LBroKerR/ESP32_Thermostats/Thermostats/configs/README.md

# included libraries
    - Arduino_JSON
    - AsyncTCP
    - DHT_kxn
    - ESP_Async_WebServer
    - ESP32Time
    - FreeRTOS
    - lvgl -> lv_conf.h (lv_config_template.h shall changed by mine cofig file)
    - ModbusMaster
    - Adafruit_SSD1306
    - TFT_eSPI -> User_Setup.h
    - WebSockets
    - WiFi
    - XPT2046_Touchscreen
