LBroKerR/ESP32_Thermostats/Summarise_pictures/README.md

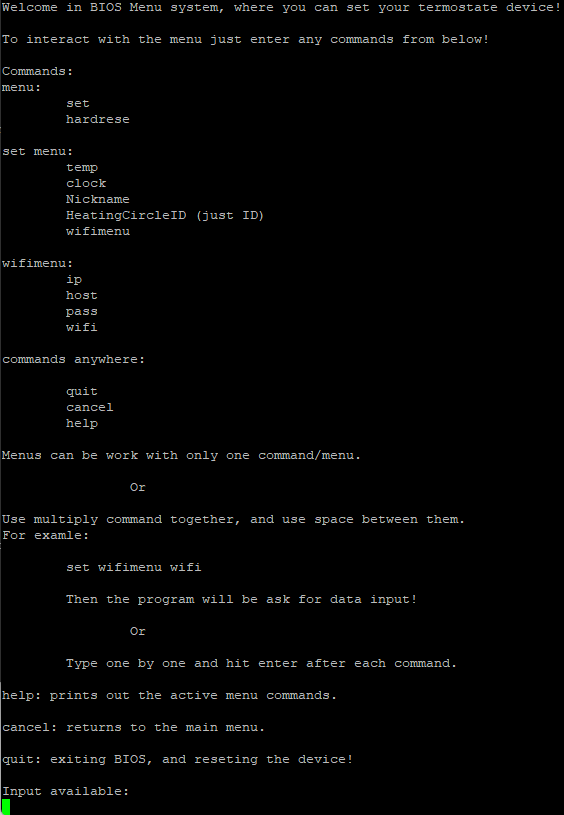
[picture p1: Summarise_pictures/serial task begining in espcarryable.png]

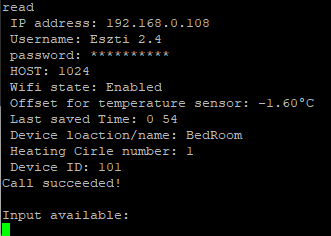
[picture p2: Summarise_pictures/eeprom read.png]

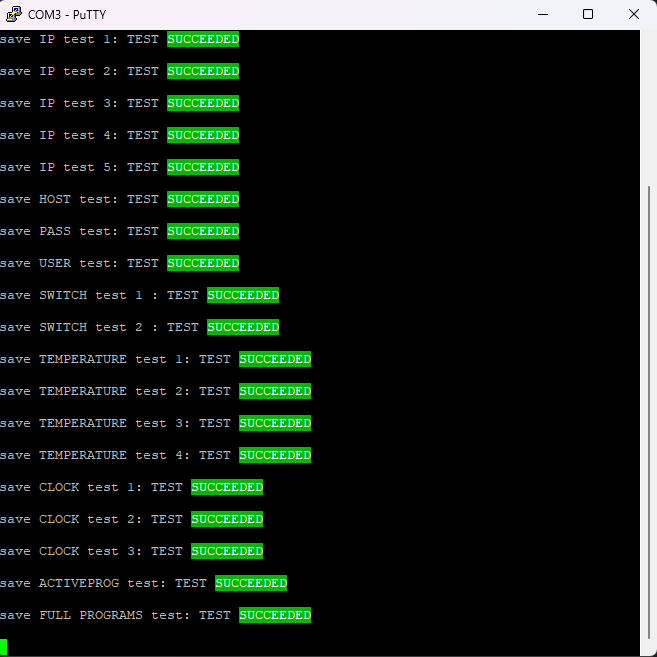
[picture p3: Summarise_pictures/eeprom test.png]

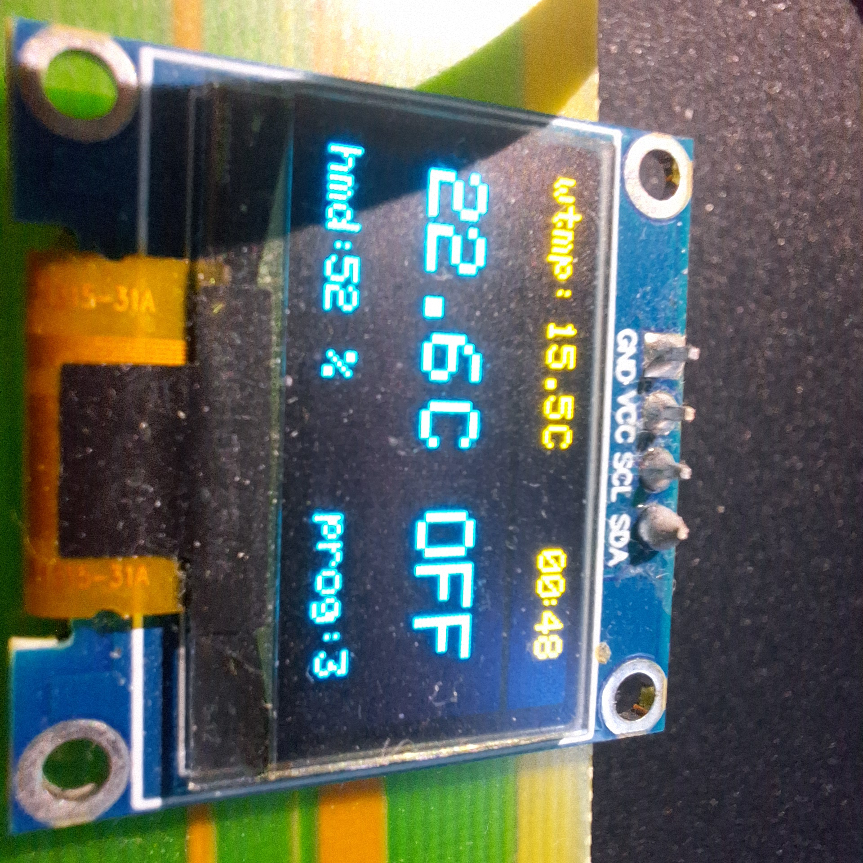
[picture p4: Summarise_pictures/espcarryable main screen.jpg]

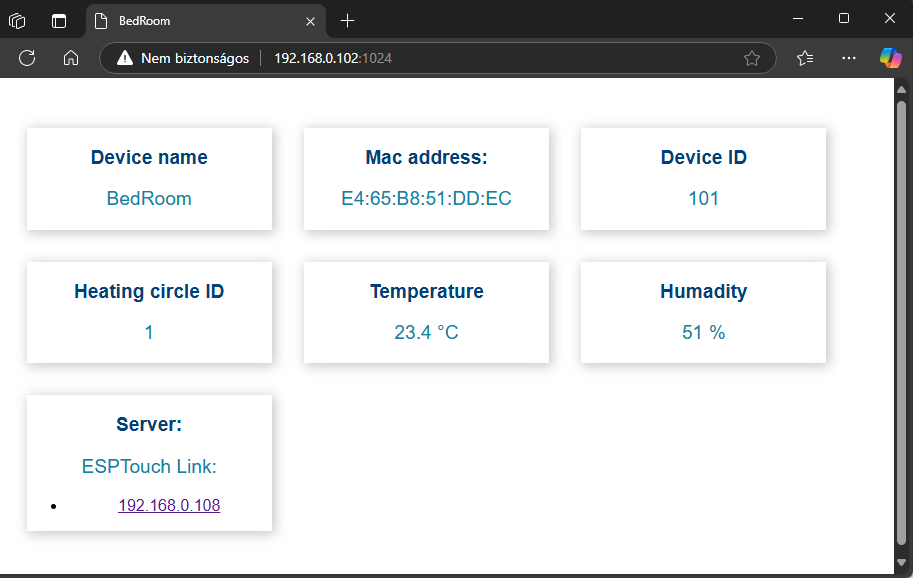
[picture p5: Summarise_pictures/espcarryable webpage.png]

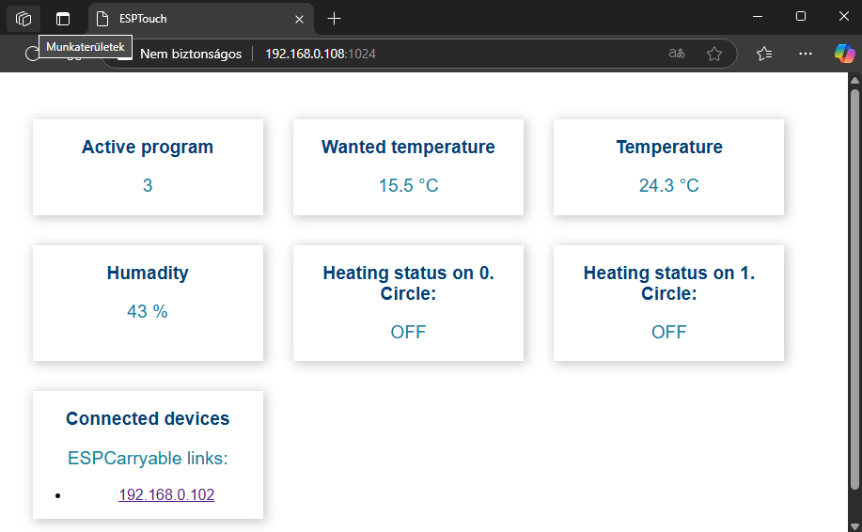
[picture p6: Summarise_pictures/esptouch webpage.png]

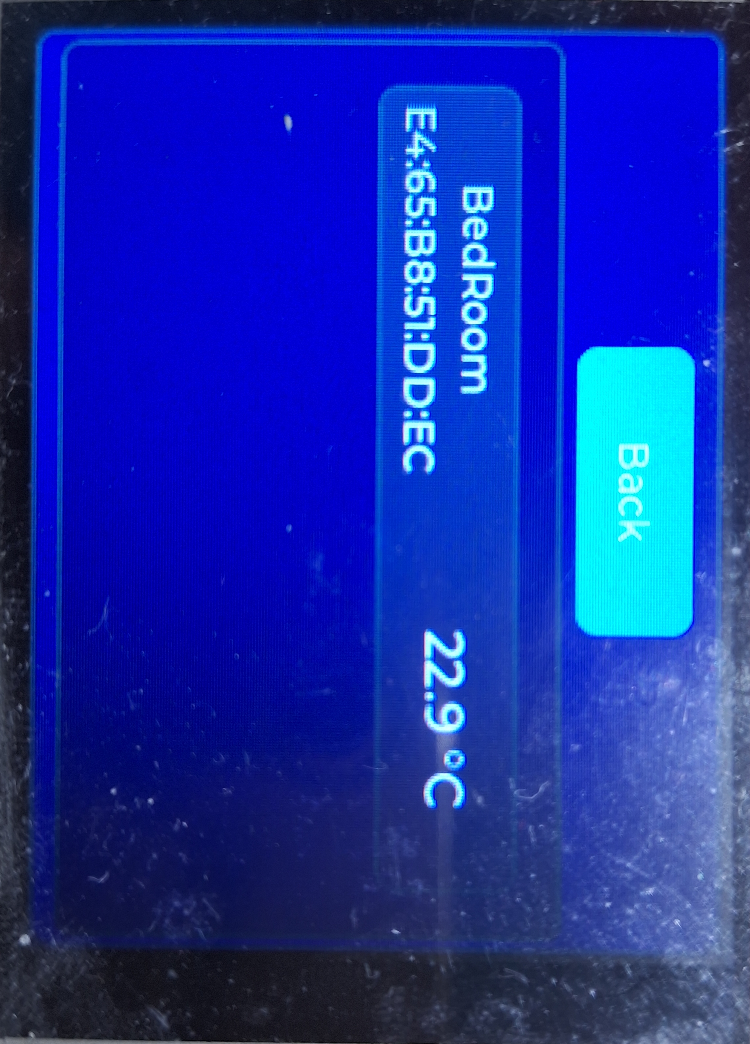
[picture p7: Summarise_pictures/external device srceen.jpg]

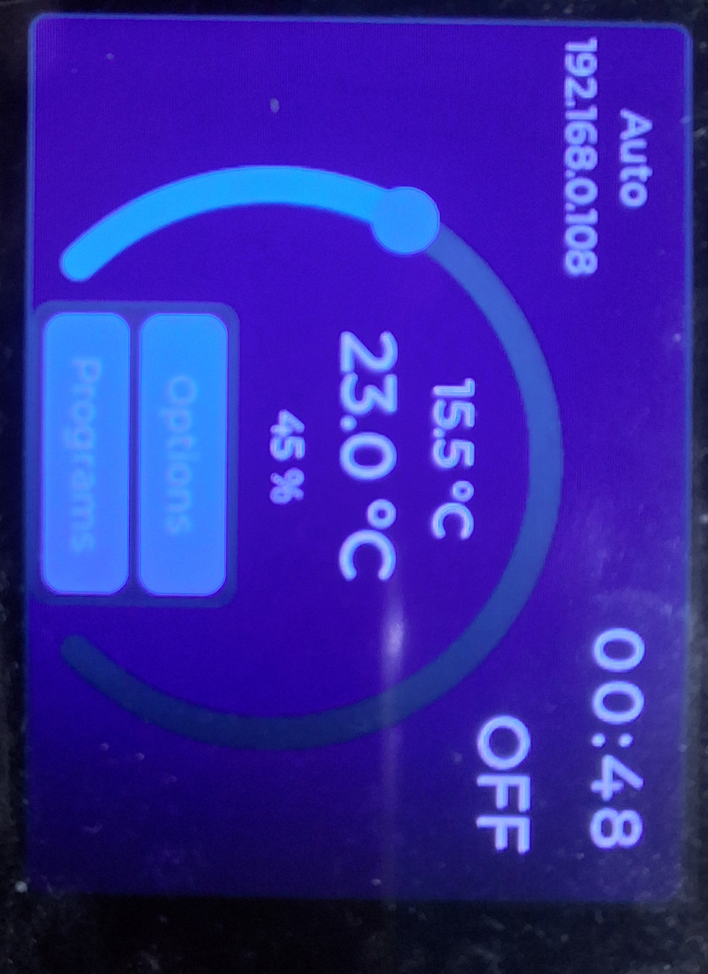
[picture p8: Summarise_pictures/main screen.jpg]

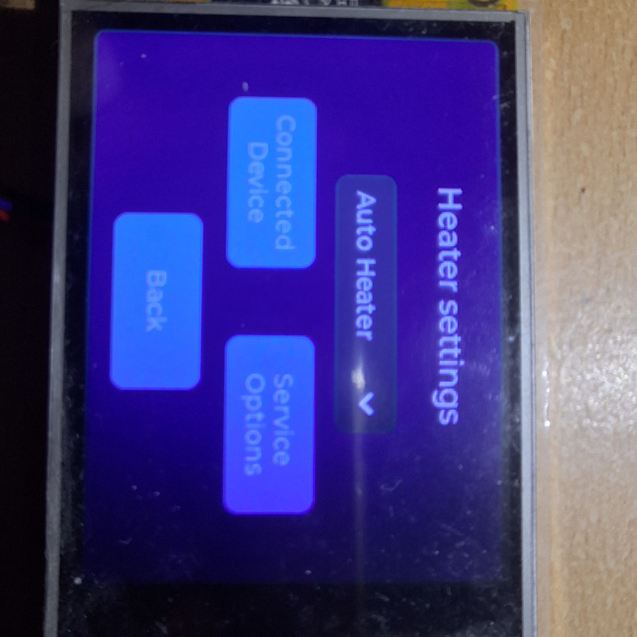
[picture p9: Summarise_pictures/options screen 2.jpg]


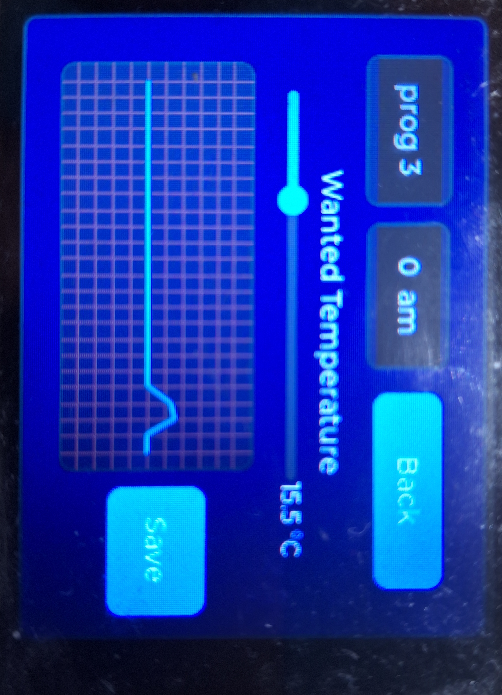
[picture p10: Summarise_pictures/prog screen.jpg]
