LBroKerR/ESP32_Thermostats/Thermostats/EspTouch/ESPTouch/Taskhandler/Init_task/InitTask.h

#pragma once
#ifndef INITTASK_H
#define INITTASK_H

#include <Arduino.h>
#include "DataHandler.h"
#include <EEPROM.h>
#include "EEPROMhandler.h"

#define EEPROM_SIZE      0x0450

#define UPSIZE           0x0015


class InitTask{
    DataHandler* WifiInit(DataHandler *obj);

    DataHandler* ProgInit(DataHandler *obj);
    DataHandler* ClockInit(DataHandler *obj);
    DataHandler* HeaterInit(DataHandler *obj);
    DataHandler* DataInit(DataHandler *obj);
    void saveData(DataHandler*);
    void print(DataHandler*parameters);
public:
    DataHandler *main(DataHandler*);
    void save(DataHandler*);
};
#endif // INITTASK_H
