LBroKerR/ESP32_Thermostats/Thermostats/Branch/ESPTouch/programs.cpp

#include "programs.h"

programs::programs(){
    active_program_index.set_variable(0);
    ProgHour_index.set_variable(0);
    active_program_index_changed=false;
    Wanted_temp.set_variable(DEFAULT_TEMP);
    wtmp_changed=false;
    manual_mode.set_variable(false);
    programs_Changed=false;
    ProgHour_index_changed=false;
    server_update_wtmp=false;
    server_update_prog_index=false;
    for(unsigned i=0; i<NUMBER_OF_PROGRAM; i++){
        Programs[i]=new float[SIZE_OF_A_PROGRAM];
        for(unsigned k=0; k<SIZE_OF_A_PROGRAM; k++){
            Programs[i][k]=DEFAULT_TEMP;
        }
    }
}
programs::~programs(){
    //void
    for(unsigned i=0; i<NUMBER_OF_PROGRAM; i++){
        delete[] Programs[i];
    }
    delete[] Programs;
}

//setters
void programs::set_server_update_prog_index(bool param){
    server_update_prog_index=param;
}
void programs::set_active_program_index(unsigned const param){
    if(param>=0 && param<NUMBER_OF_PROGRAM){
        if(active_program_index.set_variable(param)){
            set_active_program_index_changed(true);
        }
    }
}
void programs::set_Wanted_temp(float param){
    float wtmp=0.0;
    if(param>=MIN_TEMP && param<=MAX_TEMP){
        Wanted_temp.get_variable(&wtmp);
        if(wtmp!=param){
            if(Wanted_temp.set_variable(param)){
            set_server_update_wtmp(true);
            //set_wtmp_changed(true);
            }
        }
    }
}
void programs::set_programs(float* param, unsigned const size, unsigned const index){
    if(param!=nullptr && size<SIZE_OF_A_PROGRAM && size>0 && index>=0 && index<NUMBER_OF_PROGRAM){
        for(unsigned i=0; i<size; i++){
            Programs[index][i]=param[i];
        }
    }
}
    void programs::set_programs(double* param, unsigned const index){
    if(param!=nullptr && index>=0 && index<NUMBER_OF_PROGRAM){
        for(unsigned i=0; i<SIZE_OF_A_PROGRAM; i++){
            Programs[index][i]=(float)param[i];
        }
    }
}
bool programs::set_program_element( unsigned hour, float data){
    if(hour<SIZE_OF_A_PROGRAM && hour>=0 && data>=MIN_TEMP && data<=MAX_TEMP ){
        get_programs()[hour]=data;
        set_programs_Changed(true);
        return true;
    }
    return false;
}
bool programs::set_program_element( float data){
    unsigned index=0;
    if(data>=(float)MIN_TEMP && data<=(float)MAX_TEMP){
        get_ProgHour_index(&index);
        get_programs()[index]=data;
        set_programs_Changed(true);
        return true;
    }
    return false;
}

void programs::set_active_program_index_changed(bool const param){
    active_program_index_changed=param;
}
void programs::set_wtmp_changed(bool const param){
    wtmp_changed=param;
}
void programs::set_manual_mode(bool const param){
    manual_mode.set_variable(param);
}
void programs::set_programs_Changed(bool const param){
    programs_Changed=param;
}
void programs::set_ProgHour_index(unsigned param){
    unsigned tmp=0;
    get_ProgHour_index(&tmp);
    if(param!=tmp){
        ProgHour_index.set_variable(param);
        set_ProgHour_index_changed(true);
    }
}
void programs::set_ProgHour_index_changed(bool param){
        ProgHour_index_changed=param;
}
void programs::set_server_update_wtmp(bool param){
    server_update_wtmp=param;
}

void programs::set_received_index(unsigned param, unsigned hour_index){
    unsigned index=0;
    if(param>=0 && param<NUMBER_OF_PROGRAM){
        active_program_index.set_variable(param);
        set_Wanted_temp(get_programs()[hour_index]);
        set_active_program_index_changed(true);
    }
}
void programs::set_received_wtmp(float param){
    if(param>=MIN_TEMP && param<=MAX_TEMP){
       if(Wanted_temp.set_variable(param)){
        set_wtmp_changed(true);
       }
    }
}


//getters
bool programs::get_server_update_prog_index()const{
    return server_update_prog_index;
}
bool programs::get_active_program_index_changed()const{
    return active_program_index_changed;
}
bool programs::get_wtmp_changed()const{
    return wtmp_changed;
}
bool programs::get_manual_mode(bool*param){
    return manual_mode.get_variable(param);
}
bool programs::get_programs_Changed()const{
    return programs_Changed;
}

bool programs::get_active_program_index(unsigned* index){
    return active_program_index.get_variable(index);
}
bool programs::get_Wanted_temp(float *param){
    return Wanted_temp.get_variable(param);
}

float* programs::get_programs(){
    unsigned index=0;
    get_active_program_index(&index);
    return Programs[index];
}
float* programs::get_programs(unsigned index){
    if(index<NUMBER_OF_PROGRAM && index>=0){
        return  Programs[index];
    }
    return nullptr;
}

float programs::get_program_element(unsigned hour){
    float tmp=21.0;
    if(hour>=0 && hour<(unsigned)SIZE_OF_A_PROGRAM){
        tmp=get_programs()[hour];
    }
    return tmp;
}
float programs::get_program_element(){
    unsigned index=0;
    get_ProgHour_index(&index);
    return get_programs()[index];
}

bool programs::get_ProgHour_index(unsigned *index){
    return ProgHour_index.get_variable(index);
}
bool programs::get_ProgHour_index_changed()const{
    return ProgHour_index_changed;
}

bool programs::get_server_update_wtmp()const{
    return server_update_wtmp;
}
