LBroKerR/ESP32_Thermostats/Thermostats/Branch/ESPTouch/bool_mutex.cpp

#include "bool_mutex.h"

bool_mutex::bool_mutex(){
    variable=false;
    variable_mutex=xSemaphoreCreateMutex();  // Create the mutex

}

bool bool_mutex::set_variable(bool const param){
    if(variable_mutex!=nullptr){// Sanity check if the mutex exists
        if (xSemaphoreTake(variable_mutex, MUTEX_WAIT_TICKS) == pdTRUE){// Try to take the mutex and wait  MUTEX_WAIT_TICKS if needed
        // Mutex successfully taken
            variable=param; //change variable value
            xSemaphoreGive( variable_mutex);// After accessing the shared resource give the mutex and allow other processes to access it
        }
        else{
            //can not access
            return false;
        }
    }
    return true;
}
bool bool_mutex::get_variable(bool*return_value){
    if(variable_mutex!=nullptr){// Sanity check if the mutex exists
        if (xSemaphoreTake(variable_mutex, MUTEX_WAIT_TICKS) == pdTRUE){// Try to take the mutex and wait  MUTEX_WAIT_TICKS if needed
        // Mutex successfully taken
            *return_value=variable;//change variable value
            xSemaphoreGive( variable_mutex);// After accessing the shared resource give the mutex and allow other processes to access it
        }
        else{
            //can not access
            return false;
        }
    }
    return true;
}
