LBroKerR/ESP32_Thermostats/Thermostats/Branch/ESPTouch/float_mutex.cpp

#include "float_mutex.h"

float_mutex::float_mutex(){
    variable=0.0;
    variable_mutex=nullptr;
    #ifdef USE_MUTEX
     variable_mutex=xSemaphoreCreateMutex();  // Create the mutex
    #endif

}

bool float_mutex::set_variable(float const param){
#ifdef USE_MUTEX
    if(variable_mutex!=nullptr){// Sanity check if the mutex exists
        if (xSemaphoreTake(variable_mutex, MUTEX_WAIT_TICKS) == pdTRUE){// Try to take the mutex and wait  MUTEX_WAIT_TICKS if needed
        // Mutex successfully taken
#endif
            variable=param; //change variable value
#ifdef USE_MUTEX
            xSemaphoreGive( variable_mutex);// After accessing the shared resource give the mutex and allow other processes to access it
        }
        else{
            //can not access
            return false;
        }
    }
#endif
    return true;
}
bool float_mutex::get_variable(float*return_value){
    #ifdef USE_MUTEX
    if(variable_mutex!=nullptr){// Sanity check if the mutex exists
        if (xSemaphoreTake(variable_mutex, MUTEX_WAIT_TICKS) == pdTRUE){// Try to take the mutex and wait  MUTEX_WAIT_TICKS if needed
        // Mutex successfully taken
#endif
            *return_value=variable;//change variable value
#ifdef USE_MUTEX
            xSemaphoreGive( variable_mutex);// After accessing the shared resource give the mutex and allow other processes to access it
        }
        else{
            //can not access
            return false;
        }
    }
#endif
    return true;
}
