LBroKerR/ESP32_Thermostats/(commit log)

2024-11-12 device build up file uploading
2024-11-14 working but consider wtmp changes in screen1/2 _update, and should using flag to set up things correctly in screen, and send data correctly
    [GuiTask.cpp, HeatHandler.cpp, MainTask.cpp, programs.cpp, programs.h, wifiTask.cpp]
2024-11-20 serial task flowchart done
2024-11-21 init task flows
2024-11-24 html page bug fix, and documentation progress, drawio file changed while documenting
    [DeviceComponents.cpp, HTML_page.cpp, HTML_page.h, MainTask.h, P_tag.cpp, P_tag.h, UnorderedList.cpp, wifiTask.cpp]
2024-11-24 html page bug fixed which is not effected as a bug
    [UnorderedList.cpp]
2024-11-24 wtmp can be changed in esptouch via espcarryable. bug founded and fixed
    [MainTask.cpp, MyServer.cpp, wifiTask.cpp]
2024-11-25 bug fixed, any port can be us now, not just port 80
    [Clients.cpp, HTML_page.cpp, JavaScript.cpp, MyServer.cpp, wifiTask.cpp]
2024-12-02 clock sync bug fixed
    [Clock.cpp, Clock.h, MainTask.cpp, Taskhandler.cpp, styles.cpp, wifiTask.cpp]
2024-12-02 component deleting error fixed
    [Clients.cpp, Components.cpp, DeviceComponents.cpp, HeatHandler.cpp, HeatingCircleHandler.h, HeatingCirclehandler.cpp, HeatingCommunicationTask.cpp, HeatingCommunicationTask.h]
2024-12-02 heating mode bug fixed. Possible random reboot bug fixed in gui_task
    [GuiTask.cpp, MainTask.cpp]
2024-12-04 random eeprom crased solved
    [EEPROMHandler.cpp, EEPROMhandler.h, InitTask.cpp, Taskhandler.cpp]
2025-01-26 mutex vars added, new sensor stability problem solved. but looking forward to use a more reliable sensor. Clients object, element deleting not nesessary. dynamic design element problem, cant be solve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
    [Button.cpp, Button.h, Clock.cpp, Clock.h, Components.cpp, Components.h]
